pszewczyk/eq-driver/README.md

# eq-driver
A driver for equatorial telescope mounts

Sterownik napędu montażu paralaktycznego teleskopu.
Kompatybilne z EQ3-2.
