pszewczyk/eq-driver/text/main.tex

\documentclass[a4paper,11pt,twoside,openany]{book}
\usepackage{polski}
\usepackage[T1]{fontenc}
\usepackage[utf8]{inputenc}
\usepackage{gensymb}
\usepackage{graphicx}
\usepackage{svg}
\usepackage{wasysym}
\usepackage{listings}
\usepackage{tabularx}
\usepackage{fancyhdr}
\usepackage{titlesec}
\usepackage{geometry}
\graphicspath{ {images/} }

\assignpagestyle{\chapter}{fancy}

\lstset{language=C,
	tabsize=2,
	basicstyle=\footnotesize\ttfamily}

\geometry{
 a4paper,
 inner=30mm,
 outer=20mm,
 bottom=25mm,
 top=25mm,
}

\linespread{1.15}

\title{System sterowania teleskopu na montażu paralaktycznym}

\author{Paweł Szewczyk} 
\date{}

\pagestyle{fancy}
\fancyhead{}
\fancyfoot{}
\fancyfoot[RO, LE]{\thepage}
\renewcommand{\headrulewidth}{0pt}

\begin{document}

\maketitle

\tableofcontents

\chapter{Wprowadzenie do astronomii obserwacyjnej i astrofotografii}
\input{wstep.tex}

\chapter{Założenia projektowanego rozwiązania}
\input{usecase.tex}

\chapter{Protokół komunikacji: Bluetooth Low Energy}
\input{komunikacja.tex}

\chapter{Sterowanie silnikami krokowymi}
\input{silniki.tex}

\chapter{Projekt sterownika dla montażu paralaktycznego}
\input{projekt.tex}

\chapter{Interfejs użytkownika: projekt aplikacji mobilnej}

\chapter{Testy}

\chapter{Podsumowanie}

\input{literatura.tex}

\end{document}
