pszewczyk/eq-driver/text/sprzet.tex

\section{Przegląd użytych komponentów sprzętowych}

\subsection{nrf51822}

Głównym modułem zaprojektowanego urządzenia jest nrf51822. Realizuje on
jednocześnie komunikację (Bluetooth) oraz logikę sterownika.

Moduł nrf51822 oparty jest o 32-bitowy układ ARM Cortex M0. Umożliwia
komunikację z użyciem Bluetooth Low Energy.
