pszewczyk/eq-driver/eagle/proto.brd

## EAGLE design eagle/proto.brd (2017-06-06)

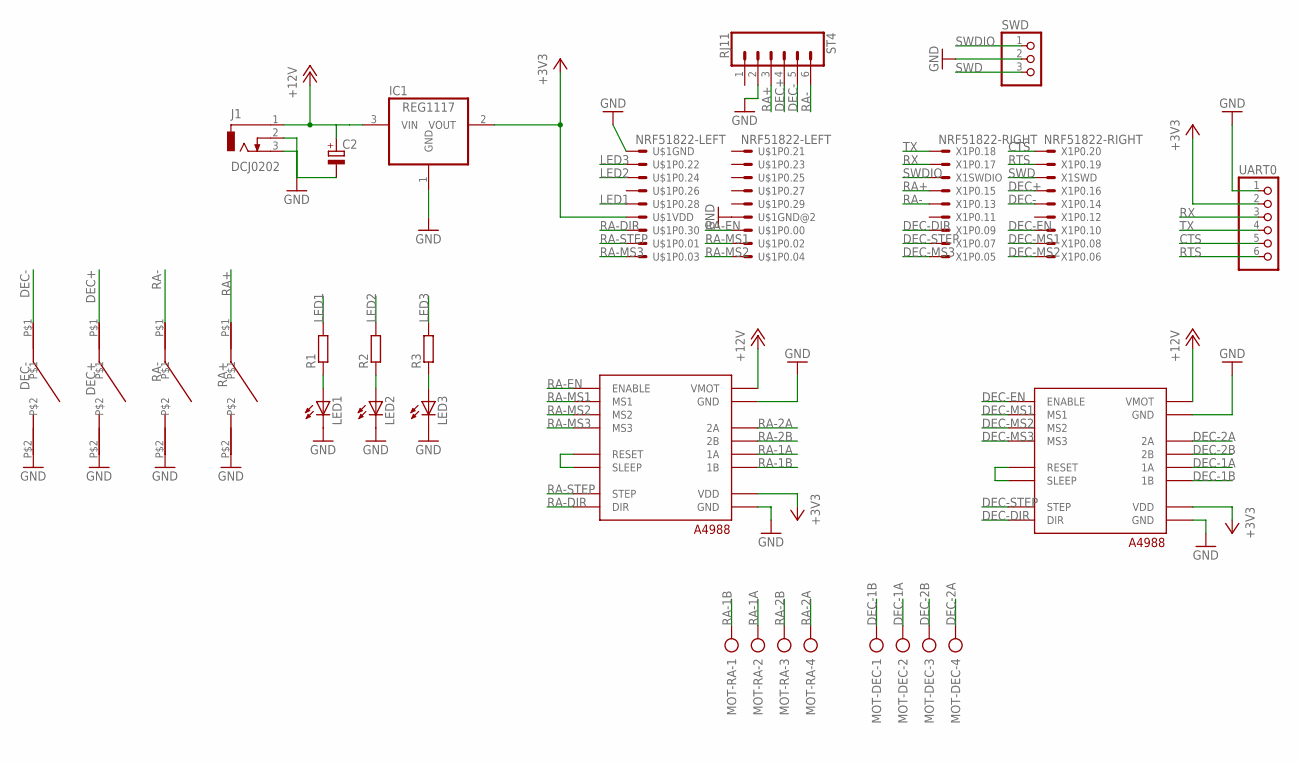
[picture p1: schematic proto.sch]

Parts:
C2: CPOL-EUSMCC; SMC_C
DEC+: TACT-SWITCH; TACT-SWITCH-THT
DEC-: TACT-SWITCH; TACT-SWITCH-THT
DRV-DEC: A4988_ALL
DRV-RA: A4988_ALL
IC1: REG1117; SOT223
J1: DCJ0202
LED1, LED2, LED3: LEDSML1206; SML1206
MOT-DEC: AK500/4
MOT-RA: AK500/4
R1, R2, R3: RR1206; R1206
RA+: TACT-SWITCH; TACT-SWITCH-THT
RA-: TACT-SWITCH; TACT-SWITCH-THT
ST4: RJ11; RJ11-6
SWD: PINHD-1X3; 1X03
U$1: NRF51822-LEFT
UART0: PINHD-1X6; 1X06
X1: NRF51822-RIGHT

Connections:
+3V3: DRV-DEC.P15 (VDD), DRV-RA.P15 (VDD), IC1.2 (VOUT), U$1.11, UART0.2
+12V: C2.+, DRV-DEC.P9 (VMOT), DRV-RA.P9 (VMOT), IC1.3 (VIN), J1.1
CTS: UART0.5, X1.2
DEC+: DEC+.P$1, ST4.4, X1.8
DEC-: DEC-.P$1, ST4.5, X1.10
DEC-1A: DRV-DEC.P13 (1A), MOT-DEC.2
DEC-1B: DRV-DEC.P14 (1B), MOT-DEC.1
DEC-2A: DRV-DEC.P11 (2A), MOT-DEC.4
DEC-2B: DRV-DEC.P12 (2B), MOT-DEC.3
DEC-DIR: DRV-DEC.P8 (DIR), X1.13
DEC-EN: DRV-DEC.P1 (ENABLE), X1.14
DEC-MS1: DRV-DEC.P2 (MS1), X1.16
DEC-MS2: DRV-DEC.P3 (MS2), X1.18
DEC-MS3: DRV-DEC.P4 (MS3), X1.17
DEC-STEP: DRV-DEC.P7 (STEP), X1.15
GND: C2.-, DEC+.P$2, DEC-.P$2, DRV-DEC.P10 (GND), DRV-DEC.P16 (GND), DRV-RA.P10 (GND), DRV-RA.P16 (GND), IC1.1 (GND), J1.2, J1.3, LED1.C, LED2.C, LED3.C, RA+.P$2, RA-.P$2, ST4.2, SWD.2, U$1.1, U$1.12, UART0.1
LED1: R1.2, U$1.9
LED2: R2.2, U$1.5
LED3: R3.2, U$1.3
unnamed: LED1.A, R1.1
unnamed: LED2.A, R2.1
unnamed: LED3.A, R3.1
unnamed: DRV-RA.P5 (RESET), DRV-RA.P6 (SLEEP)
unnamed: DRV-DEC.P5 (RESET), DRV-DEC.P6 (SLEEP)
RA+: RA+.P$1, ST4.3, X1.7
RA-: RA-.P$1, ST4.6, X1.9
RA-1A: DRV-RA.P13 (1A), MOT-RA.2
RA-1B: DRV-RA.P14 (1B), MOT-RA.1
RA-2A: DRV-RA.P11 (2A), MOT-RA.4
RA-2B: DRV-RA.P12 (2B), MOT-RA.3
RA-DIR: DRV-RA.P8 (DIR), U$1.13
RA-EN: DRV-RA.P1 (ENABLE), U$1.14
RA-MS1: DRV-RA.P2 (MS1), U$1.16
RA-MS2: DRV-RA.P3 (MS2), U$1.18
RA-MS3: DRV-RA.P4 (MS3), U$1.17
RA-STEP: DRV-RA.P7 (STEP), U$1.15
RTS: UART0.6, X1.4
RX: UART0.3, X1.3
SWD: SWD.3, X1.6
SWDIO: SWD.1, X1.5
TX: UART0.4, X1.1

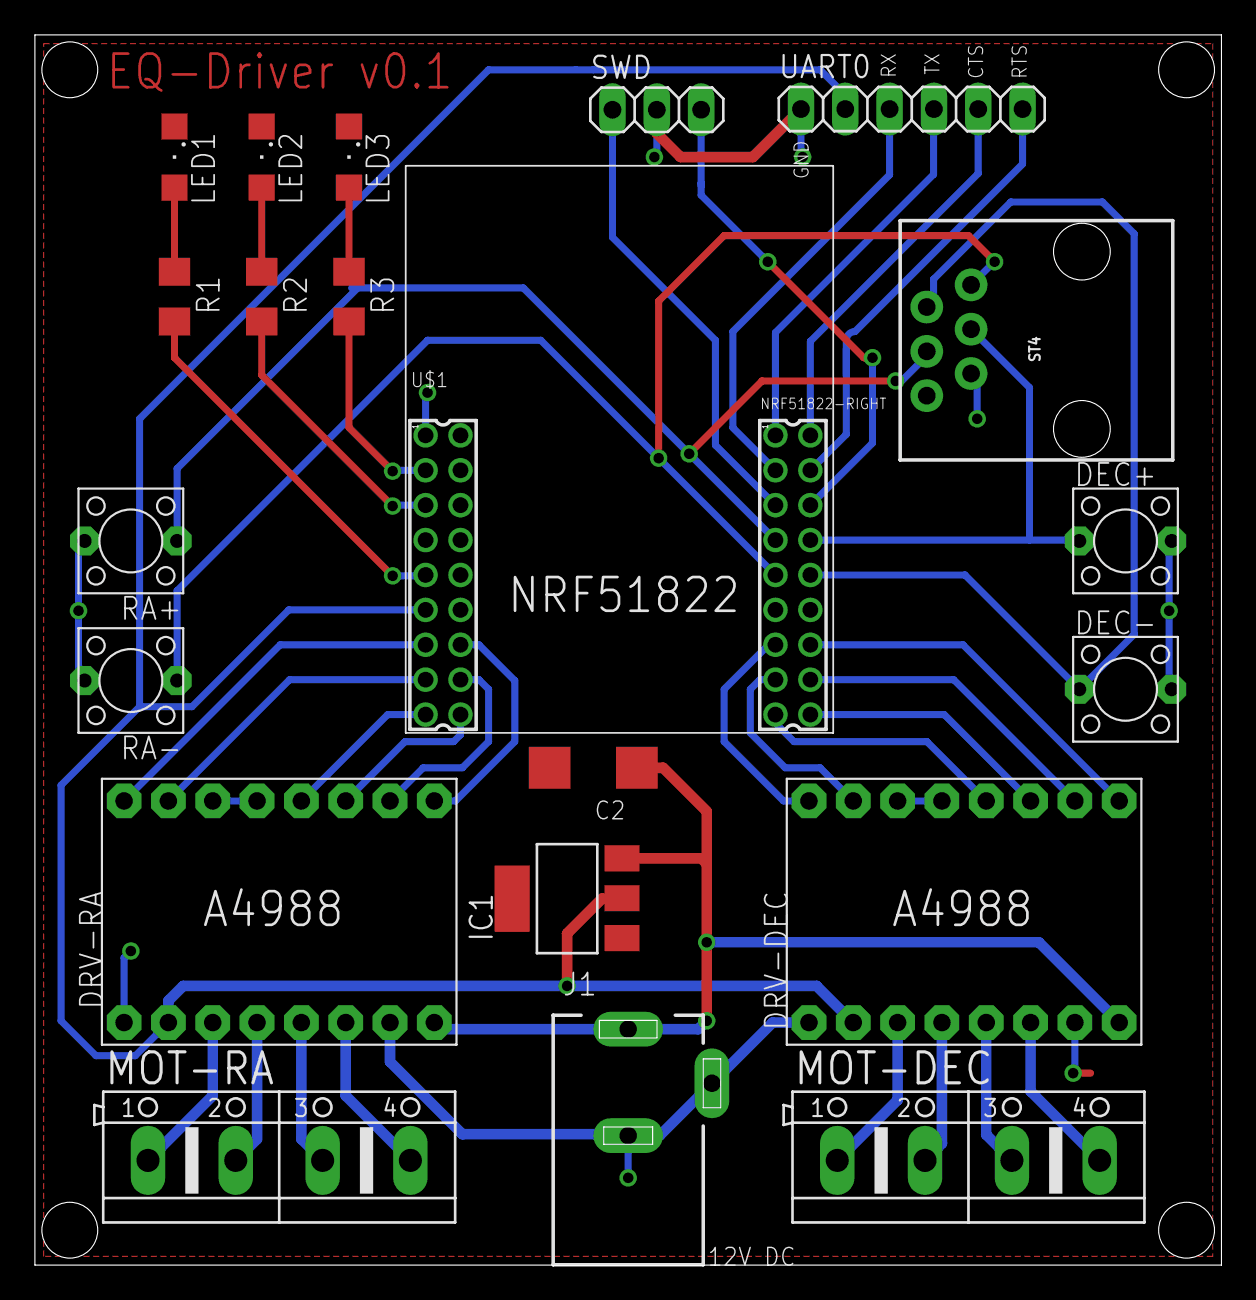
[picture p2: board proto.brd from above]

Board: 2 copper layers, 68.0 x 70.5 mm, 22 parts (0 on the bottom side), 41 nets.
