pszewczyk/eq-driver/nrf51/config/custom_board.h

/* This is custom board definition */

/* BLE400 board has some useful features like keys and leds */

#define KEY1 16
#define KEY2 17

#define KEY_RAP 16
#define KEY_RAM 17
#define KEY_DECP 14
#define KEY_DECM 15
 
#define LED0 18
#define LED1 19
#define LED2 20
#define LED3 21
#define LED4 22

#define CPCTS 8
#define CPRTS 10
#define CPRX 9
#define CPTX 11

#define RA_EN 0
#define RA_DIR 30
#define RA_STEP 1
#define RA_MS1 2
#define RA_MS2 4
#define RA_MS3 3

#define DEC_EN 10
#define DEC_DIR 9
#define DEC_STEP 7
#define DEC_MS1 8
#define DEC_MS2 6
#define DEC_MS3 5
