pszewczyk/eq-driver/(commit log)

2017-03-23 Add BLE400 pinout definition
    BLE400 have some useful features, probably the pinout will be copied in final board design.
2017-03-26 Add a timer
    Add correct implementation of a timer, not so obvious actually.
    [main.c]
2017-03-29 Enable loggin debug messages over UART
2017-04-04 Add board prototype
    It's one-sided board to cut the cost. Without some functionalities.
    Includes some lbr files for nrf51822 and a4988
    [proto.brd, proto.sch]
2017-04-05 Add motor-related timers
2017-04-08 Enable writing charatecteristics by external devices
2017-04-09 WIP: Add android App
    This is just PoC of android client for the driver.
2017-05-01 Add button handling and improve error handling
    [eq_ble.c, main.c]
2017-05-01 goto: Fix spherical out of bounds problems
    [main.c]
2017-05-09 eagle: Kolejna wersja prototypu
    [proto.brd, proto.sch]
2017-05-23 board: Change some elements to smd
    [proto.brd, proto.sch]
2017-05-25 Change more elements to smd
    [proto.brd, proto.sch]
2017-06-06 Fix disabled DEC motor in tracking mode
    [main.c]
2017-06-06 eagle: Add ST4 port
    [proto.brd, proto.sch]
